blackmagic-debug/blackmagic-hardware/README.md

This project has now moved to [codeberg](https://codeberg.org/blackmagic-debug/blackmagic-hardware). Please file any issues and pull
requests there.
