blackmagic-debug/blackmagic-hardware/(list of files, drawings)

Other design files:
blackmagic.pcb
blackmagic_mini.pcb
contrib/bmp2/bmp2.pcb
contrib/emeb/bmp2.pcb
