blackmagic-debug/blackmagic-hardware/contrib/richardeoin/blackmagic_richardeoin.brd

## EAGLE design contrib/richardeoin/blackmagic_richardeoin.brd (2013-09-04, last stored version)

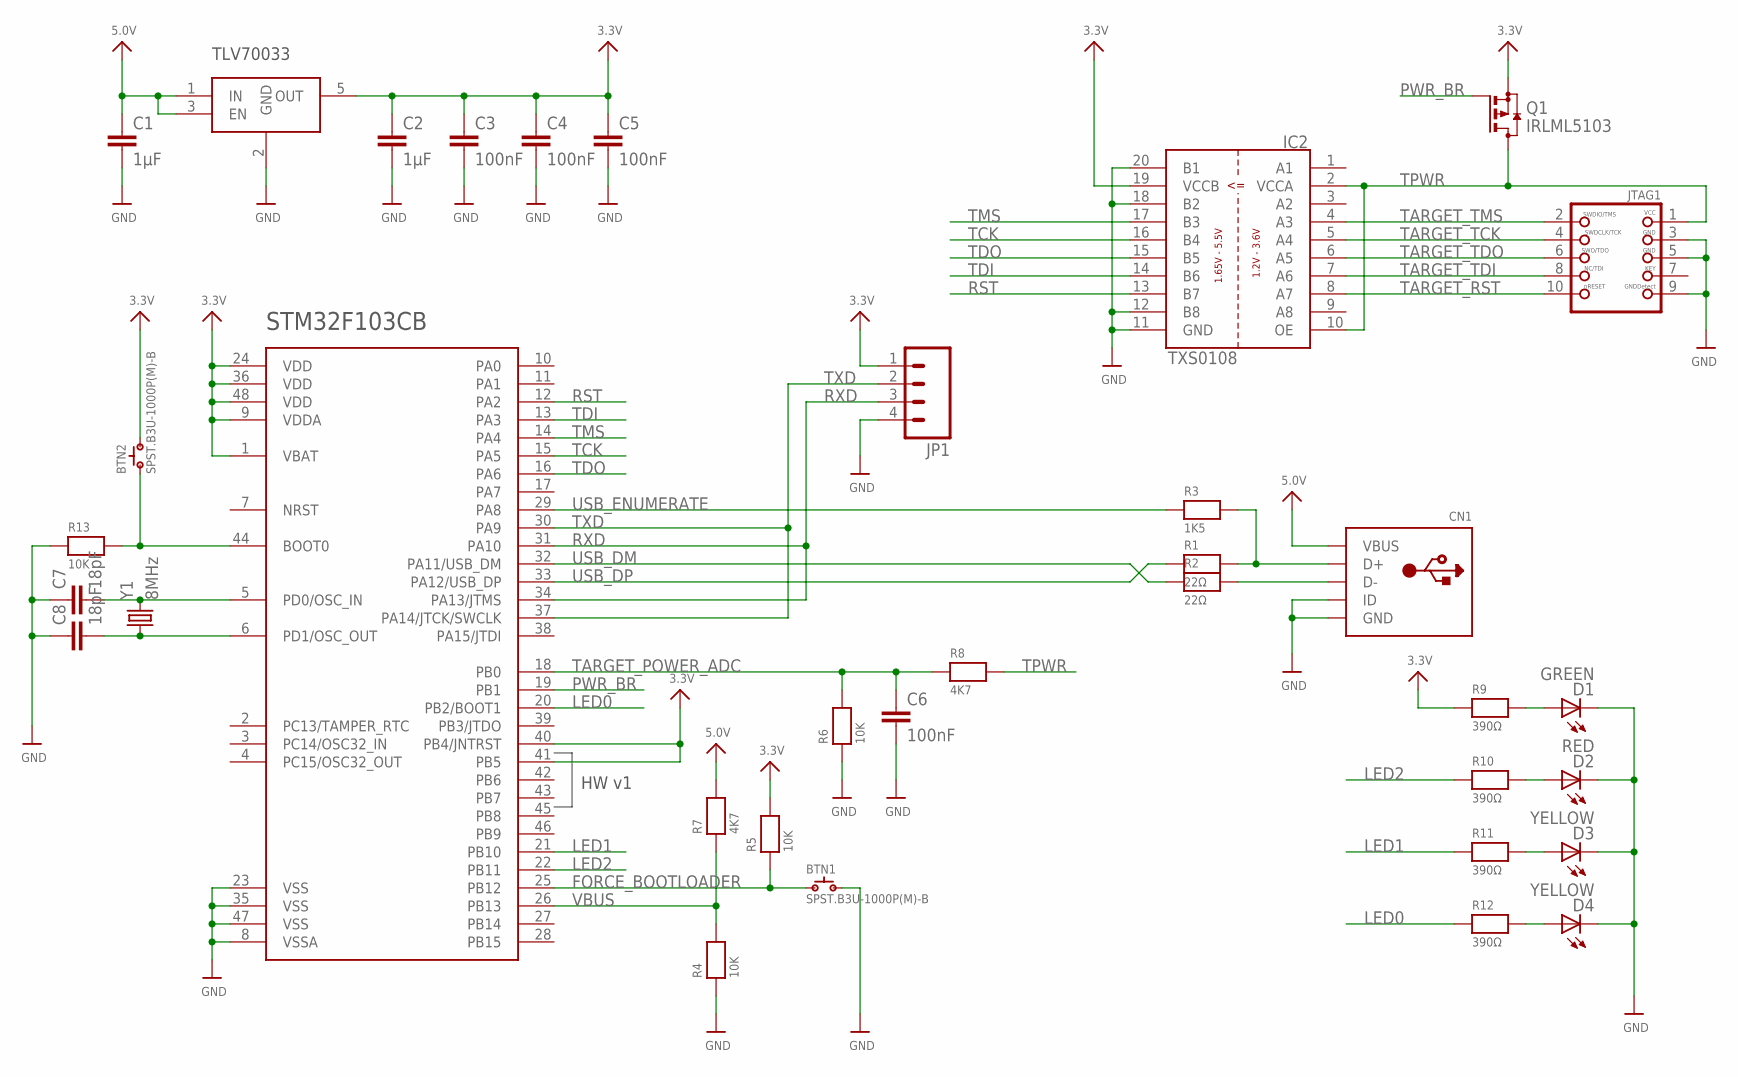
[picture p1: schematic blackmagic_richardeoin.sch]

Parts:
BTN1, BTN2: SPST.B3U-1000P(M)-B; B3U-1000P(M)-B
C1, C2: 1µF; C0603K
C3, C4, C5, C6: 100nF; C0603K
C7, C8: 18pF; C0603K
CN1: USBMINIB; USB-MINIB
D1: GREEN; CHIPLED_0603
D2: RED; CHIPLED_0603
D3, D4: YELLOW; CHIPLED_0603
IC1: STM32F_48PIN; TQFP48
IC2: TXS0108; TSSOP20
IC3: TLV70033DCK; SC70-5L
JP1: M04LOCK; 1X04_LOCK
JTAG1: JTAG-CORTEXM3; 2X05_1.27MM_SMT
Q1: IRLML5103; SOT23
R1, R2: 22Ω; 0603-MINI
R3: 1K5; 0603-MINI
R4, R5, R6, R13: 10K; 0603-MINI
R7, R8: 4K7; 0603-MINI
R9, R10, R11, R12: 390Ω; 0603-MINI
Y1: 8MHz; CRYSTAL-SMD-5X3

Connections:
3.3V: BTN2.2, C2.1, C3.1, C4.1, C5.1, IC1.1 (VBAT), IC1.9 (VDDA), IC1.24 (VDD), IC1.36 (VDD), IC1.40 (PB4/JNTRST), IC1.41 (PB5), IC1.48 (VDD), IC2.19 (VCCB), IC3.5 (OUT), JP1.1, Q1.2 (S), R5.2, R9.1
5.0V: C1.1, CN1.VBUS, IC3.1 (IN), IC3.3 (EN), R7.2
BOOT0: BTN2.1, IC1.44 (BOOT0), R13.2
D+: CN1.D+, R1.2, R3.2
D-: CN1.D-, R2.2
FORCE_BOOTLOADER: BTN1.1, IC1.25 (PB12), R5.1
GND: BTN1.2, C1.2, C2.2, C3.2, C4.2, C5.2, C6.2, C7.1, C8.1, CN1.GND, CN1.ID, D1.C, D2.C, D3.C, D4.C, IC1.8 (VSSA), IC1.23 (VSS), IC1.35 (VSS), IC1.47 (VSS), IC2.11 (GND), IC2.12 (B8), IC2.18 (B2), IC2.20 (B1), IC3.2 (GND), JP1.4, JTAG1.3, JTAG1.5, JTAG1.9, R4.1, R6.1, R13.1
LED0: IC1.20 (PB2/BOOT1), R12.1
LED1: IC1.21 (PB10), R11.1
LED2: IC1.22 (PB11), R10.1
LPC_XTAL2: C8.2, IC1.6 (PD1/OSC_OUT), Y1.1
unnamed: D2.A, R10.2
unnamed: D1.A, R9.2
unnamed: D3.A, R11.2
unnamed: D4.A, R12.2
OSC_IN: C7.2, IC1.5 (PD0/OSC_IN), Y1.3 (2)
PWR_BR: IC1.19 (PB1), Q1.1 (G)
RST: IC1.12 (PA2), IC2.13 (B7)
RXD: IC1.31 (PA10), IC1.34 (PA13/JTMS), JP1.3
TARGET_POWER_ADC: C6.1, IC1.18 (PB0), R6.2, R8.1
TARGET_RST: IC2.8 (A7), JTAG1.10
TARGET_TCK: IC2.5 (A4), JTAG1.4
TARGET_TDI: IC2.7 (A6), JTAG1.8
TARGET_TDO: IC2.6 (A5), JTAG1.6
TARGET_TMS: IC2.4 (A3), JTAG1.2
TCK: IC1.15 (PA5), IC2.16 (B4)
TDI: IC1.13 (PA3), IC2.14 (B6)
TDO: IC1.16 (PA6), IC2.15 (B5)
TMS: IC1.14 (PA4), IC2.17 (B3)
TPWR: IC2.2 (VCCA), IC2.10 (OE), JTAG1.1, Q1.3 (D), R8.2
TXD: IC1.30 (PA9), IC1.37 (PA14/JTCK/SWCLK), JP1.2
USB_DM: IC1.32 (PA11/USB_DM), R2.1
USB_DP: IC1.33 (PA12/USB_DP), R1.1
USB_ENUMERATE: IC1.29 (PA8), R3.1
VBUS: IC1.26 (PB13), R4.2, R7.1

Notes on the sheet:
STM32F103CB
HW v1
TLV70033

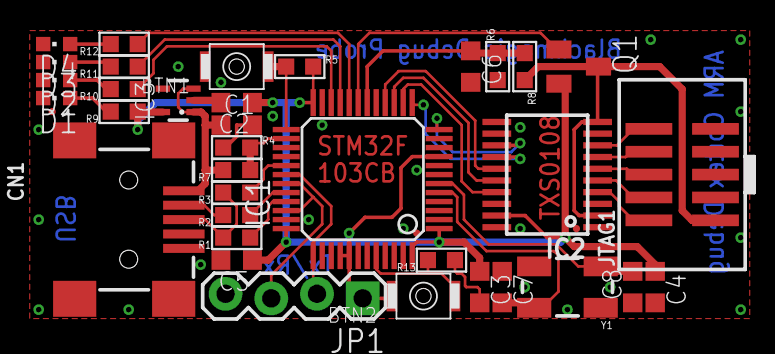
[picture p2: board blackmagic_richardeoin.brd from above]

Board: 2 copper layers, 35 parts (0 on the bottom side), 35 nets.
