blackmagic-debug/blackmagic-hardware/bmp_entropia.brd

## EAGLE design contrib/entropia/bmp_entropia.brd (2013-03-16, last stored version)

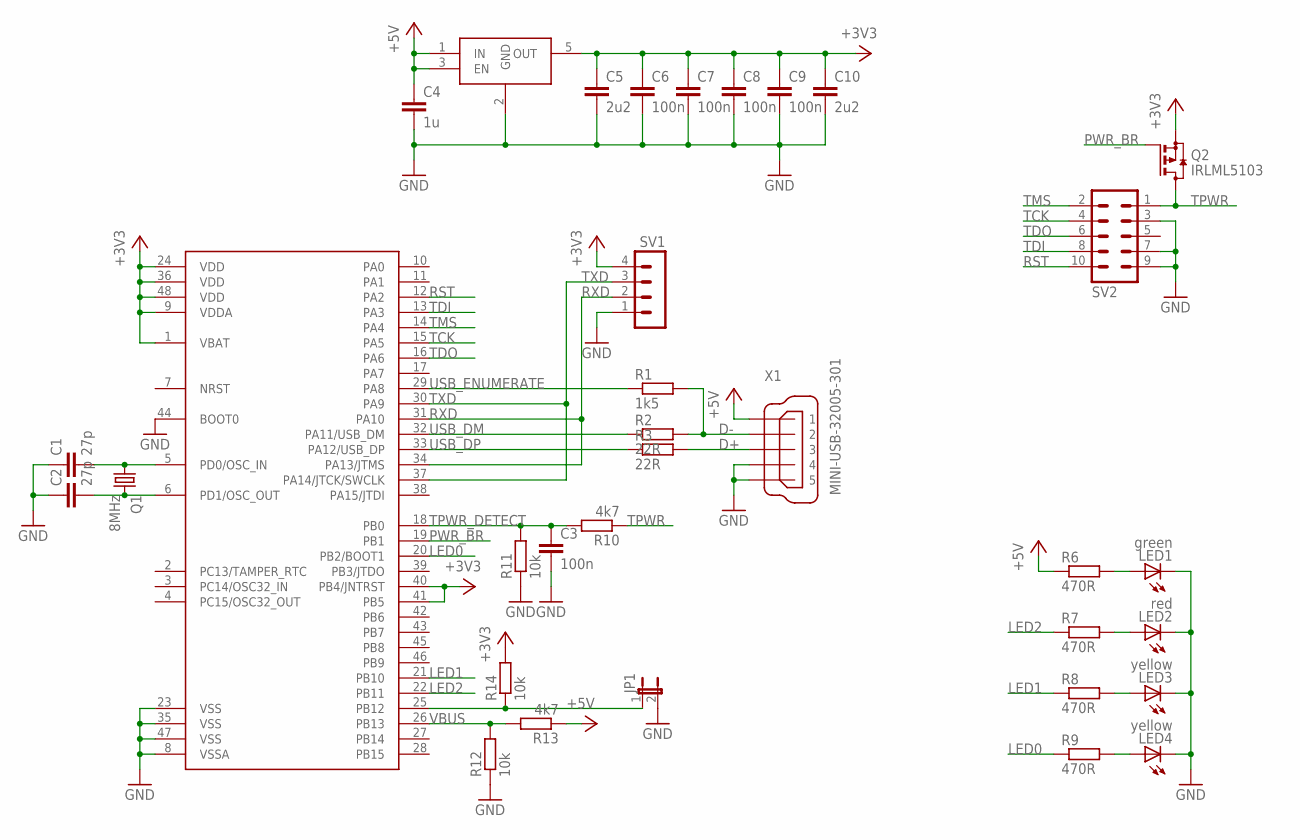
[picture p3: schematic bmp_entropia.sch]

Parts:
C1, C2: 27p; C0603
C3, C6, C7, C8, C9: 100n; C0603
C4: 1u; C0603
C5, C10: 2u2; C0603
JP1: JP1E; JP1
LED1: green; CHIPLED_0603
LED2: red; CHIPLED_0603
LED3, LED4: yellow; CHIPLED_0603
Q1: 8MHz; HC49/S
Q2: IRLML5103; SOT23
R1: 1k5; R0603
R2, R3: 22R; R0603
R6, R7, R8, R9: 470R; R0603
R10, R13: 4k7; R0603
R11, R12, R14: 10k; R0603
SV1: MA04-1
SV2: MA05-2
U$1: STM32F_48PIN; TQFP48
U$2: TLV70033DCK; SC70-5L
X1: MINI-USB-32005-301; 32005-301

Connections:
+3V3: C5.1, C6.1, C7.1, C8.1, C9.1, C10.1, Q2.2 (S), R14.2, SV1.4, U$1.1 (VBAT), U$1.9 (VDDA), U$1.24 (VDD), U$1.36 (VDD), U$1.40 (PB4/JNTRST), U$1.41 (PB5), U$1.48 (VDD), U$2.5 (OUT)
+5V: C4.1, R6.1, R13.1, U$2.1 (IN), U$2.3 (EN), X1.1
D+: R3.2, X1.3
D-: R1.2, R2.2, X1.2
GND: C1.1, C2.1, C3.2, C4.2, C5.2, C6.2, C7.2, C8.2, C9.2, C10.2, JP1.2, LED1.C, LED2.C, LED3.C, LED4.C, R11.1, R12.1, SV1.1, SV2.3, SV2.7, SV2.9, U$1.8 (VSSA), U$1.23 (VSS), U$1.35 (VSS), U$1.44 (BOOT0), U$1.47 (VSS), U$2.2 (GND), X1.4, X1.5
LED0: R9.1, U$1.20 (PB2/BOOT1)
LED1: R8.1, U$1.21 (PB10)
LED2: R7.1, U$1.22 (PB11)
LED_G: LED1.A, R6.2
LED_R: LED2.A, R7.2
LED_Y0: LED4.A, R9.2
LED_Y1: LED3.A, R8.2
OSC_IN: C1.2, Q1.1, U$1.5 (PD0/OSC_IN)
OSC_OUT: C2.2, Q1.2, U$1.6 (PD1/OSC_OUT)
PWR_BR: Q2.1 (G), U$1.19 (PB1)
RST: SV2.10, U$1.12 (PA2)
RXD: SV1.2, U$1.31 (PA10), U$1.34 (PA13/JTMS)
TASTER: JP1.1, R14.1, U$1.25 (PB12)
TCK: SV2.4, U$1.15 (PA5)
TDI: SV2.8, U$1.13 (PA3)
TDO: SV2.6, U$1.16 (PA6)
TMS: SV2.2, U$1.14 (PA4)
TPWR: Q2.3 (D), R10.1, SV2.1
TPWR_DETECT: C3.1, R10.2, R11.2, U$1.18 (PB0)
TXD: SV1.3, U$1.30 (PA9), U$1.37 (PA14/JTCK/SWCLK)
USB_DM: R2.1, U$1.32 (PA11/USB_DM)
USB_DP: R3.1, U$1.33 (PA12/USB_DP)
USB_ENUMERATE: R1.1, U$1.29 (PA8)
VBUS: R12.2, R13.2, U$1.26 (PB13)

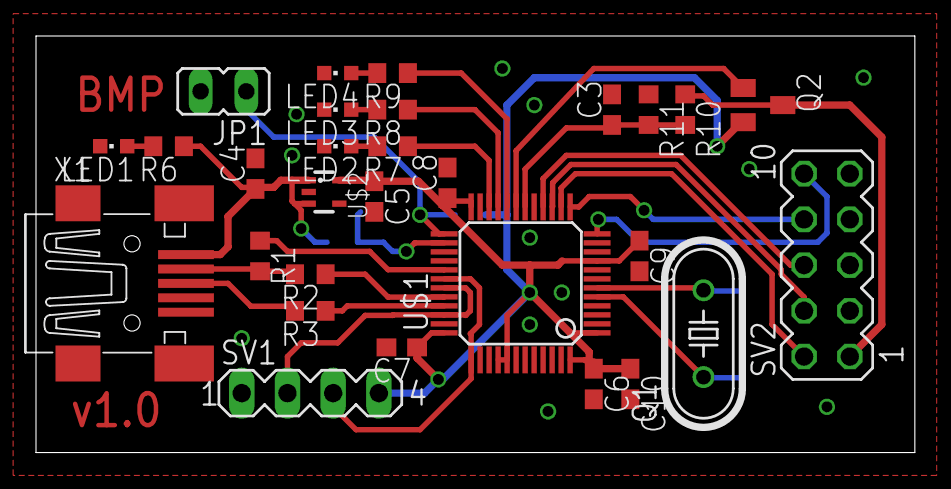
[picture p4: board bmp_entropia.brd from above]

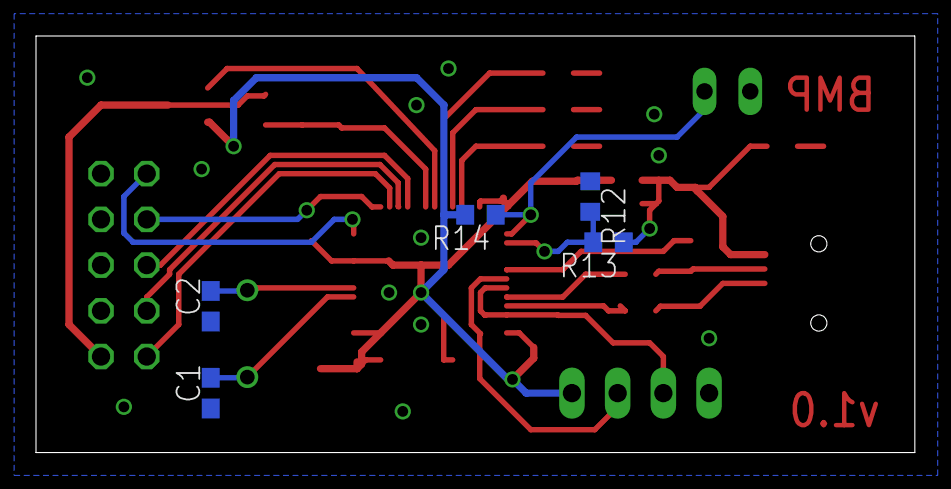
[picture p5: board bmp_entropia.brd from below]

Board: 2 copper layers, 48.8 x 23.1 mm, 34 parts (5 on the bottom side), 29 nets.
