blackmagic-debug/blackmagic-hardware/(threads)

Thread 1 (2018-08-16):

Feature request: USB-C

tkornack, 2018-08-16:
USB-C is the only port on my computer and blackmagic is the only hardware I use without USB-C. Ignore the differential pins and just change the connector (plus the two pulldown resistors necessary for orientation negotiation.)

incyi, 2019-03-14:
I agree with this.

rs-development, 2020-07-19:
I just added a new PR. https://github.com/blacksphere/blackmagic-hardware/pull/5 We are working on an updated BMP with USB-C.

Comment or like if you don't mind.

esden, 2022-09-01:
Thank you @tkornack we have now added USB-C to the official Black Magic Probe V2.3 hardware. It is available from [1BitSquared USA](https://1bitsquared.com/products/black-magic-probe) and [1BitSquared Germany](https://1bitsquared.de/products/black-magic-probe). :)

Closed 2022-09-01.

Thread 3 (2020-02-01):

Blackmagic mini 2.1C PCB Files

forthnutter, 2020-02-01:
I looked at downloaded files from this repo
found the PCB's don't look anything like BMPM 2.1c PCB.
Is there anywhere else I can download the BMPM 2.1C PCB files

esden, 2022-09-01:
Sorry @ajsb85 but that is too open of a forum for that. People can DM me an nicely ask for the design files explaining what they want to do with them. The schematics are published for most of the designs on the website already: https://black-magic.org/hardware.html

Closed 2022-09-01.

Thread 4 (2020-04-22):

Licence

mchodzikiewicz, 2020-04-22:
Hi,

What licence is Blackmagic Probe hardware under?

ajsb85, 2022-09-01:
Hi, @mchodzikiewicz

When it is not explicitly published in a public repository you can expect that it is in Public Domain.

https://wiki.creativecommons.org/wiki/public_domain

Cheers.

dragonmux, 2022-09-01:
To answer the original question the license is Creative Commons CC-BY-SA 4.0, and the schematics are available by request from the 1bitsquared Discord server.

mchodzikiewicz, 2022-09-01:
Hmm, I was pretty suspicous about that claim :smile:
thanks for the clarification @dragonmux this might be a good call to resume my project idea from a coma :slightly_smiling_face:

esden, 2022-09-01:
I will be adding the schematics that are already published on the website https://black-magic.org/hardware.html to this repository. The schematics are available under CC-BY-SA license.

Some older hardware is licensed similarly, but the files are only available by request if you talk to me personally.

For some context why I am not just publishing the design files. This project is only being properly maintained thanks to the hardware sales. All the flurry of activity in the firmware repository is because I am taking the funds from BMP sales and pay people to work on the project. There are too many lazy "businesspeopele" that comb the internet for well documented open source hardware to produce and flood various websites with for small profit. They do not contribute to the continuing development maintenance and support of the project. This did happen with my other projects so I will not be openly publishing the files. That said anyone who buys Black Magic Probe from us is welcome to ask for the documentation they need for their use, which obviously includes the schematics. If you would like to design derivative hardware also, please talk to us. You can send me an email to info at 1bitsquared.com or DM me on [discord](https://1bitsquared.com/pages/chat). There are some rules to it but we do help out where we can. If you can't afford the hardware from us there is plenty of low cost hardware we officially support. ST-Link bluepill, blackpill and so on.

I hope this explains it. Let me know if you have additional questions.
