blackmagic-debug/blackmagic-hardware/(commit log)

2011-02-06 Added Black Magic Probe schematic.
    [blackmagic.sch]
2011-02-06 Fixed schematic to match old netlist.
    [blackmagic.sch]
2011-02-06 Added PCB layout.
    [blackmagic.pcb]
2011-02-06 Added copyright notice to pcb layout.
    [blackmagic.pcb]
2011-02-06 Named PCB layout.
    [blackmagic.pcb]
2011-02-08 Added some missing values and footprints to schematic.
    [blackmagic.sch]
2012-03-25 Added new mini hardware design.
    [blackmagic_mini.pcb, blackmagic_mini.sch]
2012-04-02 hardware: Removed solder paste openings on fiducials.
    [blackmagic_mini.pcb]
2013-03-16 Add a version of BMP-mini optimized for manual production
    This commit adds a variant of the Blackmagic Mini that uses only 0603
    parts and standard connectors for better availability and easier manual
    soldering.
    Additionally, another voltage regulator has been used that is
    cheaper, pin-compatible and has better characteristics.
    [bmp_entropia.brd, bmp_entropia.sch]
2013-03-16 Moved entropia design to contrib directory and added description.
    [bmp_entropia.brd, bmp_entropia.sch]
2013-03-17 Modified BMP Mini with extra connectors
    [bmp2.pcb, bmp2.sch]
2013-06-18 hardware: Correct micro part number to STM32F103CB.
    [blackmagic_mini.sch]
2013-08-18 Added new contrib hardware folder including README
    [blackmagic_richardeoin.brd, blackmagic_richardeoin.sch]
2013-08-18 Majority of Components in place
    [blackmagic_richardeoin.brd, blackmagic_richardeoin.sch]
2013-08-18 Added LEDs
    [blackmagic_richardeoin.brd, blackmagic_richardeoin.sch]
2013-08-19 Schematic provisionally complete
    [blackmagic_richardeoin.brd, blackmagic_richardeoin.sch]
2013-08-19 Completed board layout
    [blackmagic_richardeoin.brd, blackmagic_richardeoin.sch]
2013-08-19 Changed text on the end of the board to "ARM Cortex Debug"
    [blackmagic_richardeoin.brd, blackmagic_richardeoin.sch]
2013-08-19 Added switch on BOOT0
    [blackmagic_richardeoin.brd, blackmagic_richardeoin.sch]
2013-08-19 Removed mouse cursor from board image!
2013-08-19 Added pdf of schematic
2013-09-04 Renamed schematic PDF
2013-09-04 Made all the board layers visible
    [blackmagic_richardeoin.brd]
2013-09-04 Added assembly photos
2013-09-04 Added more description about the BOOT0 pin
2013-09-04 Fixed Assembly photo
2013-09-04 Added assembly descriptions
2013-09-04 Tided up README, added note about board being proven
2013-09-04 Made assembly notes titles
2022-09-01 Rename contributed hardware design and add info + images.
    [bmp2.pcb, bmp2.sch, bom.xls]
2026-02-23 We moved to codeberg. See README
    [blackmagic.pcb, blackmagic.sch, blackmagic_mini.pcb, blackmagic_mini.sch, blackmagic_richardeoin.brd, blackmagic_richardeoin.sch, bmp2.pcb, bmp2.sch]
